sondrehr/Flight_Controller/Drone Pictures/Error codes.PNG

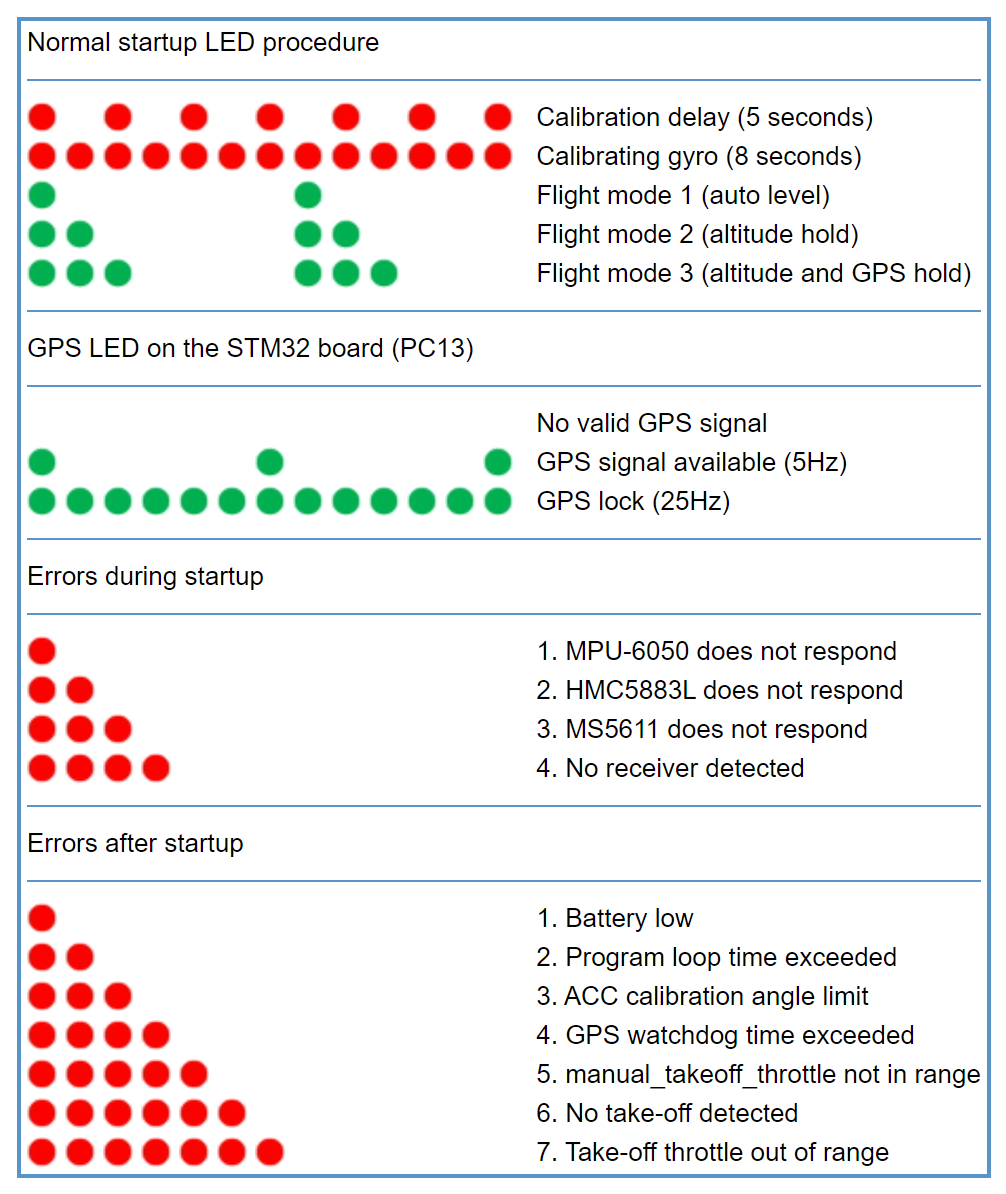
Drone Pictures/Error codes.PNG
