sondrehr/Flight_Controller/Drone Pictures/IMG_20191018_124647.jpg

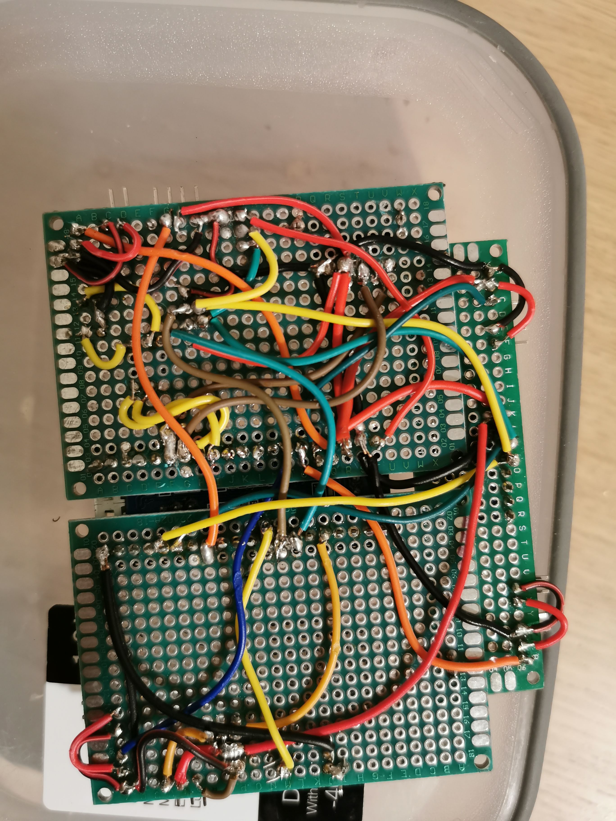
Drone Pictures/IMG_20191018_124647.jpg
