sondrehr/Flight_Controller/Drone Pictures/IMG_20191018_124652.jpg

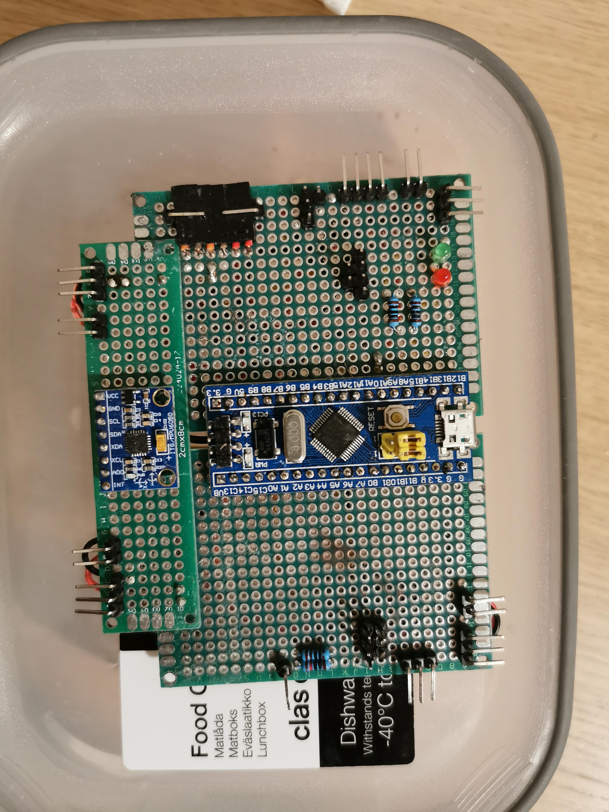
Drone Pictures/IMG_20191018_124652.jpg
