sondrehr/Flight_Controller/Drone Pictures/IMG_20200118_231146.jpg

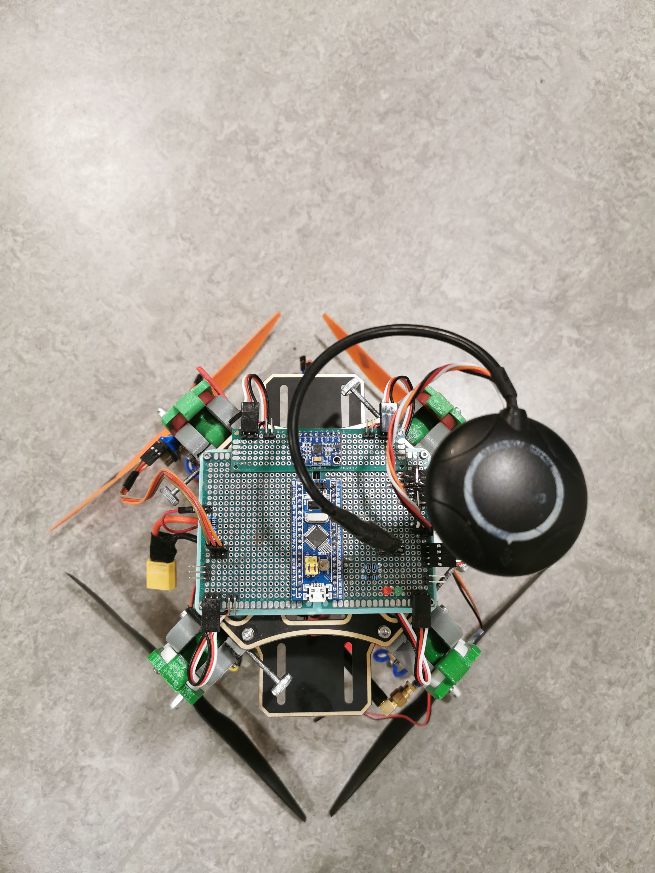
Drone Pictures/IMG_20200118_231146.jpg
