sondrehr/Flight_Controller/Drone Pictures/IMG_20210730_152356.jpg

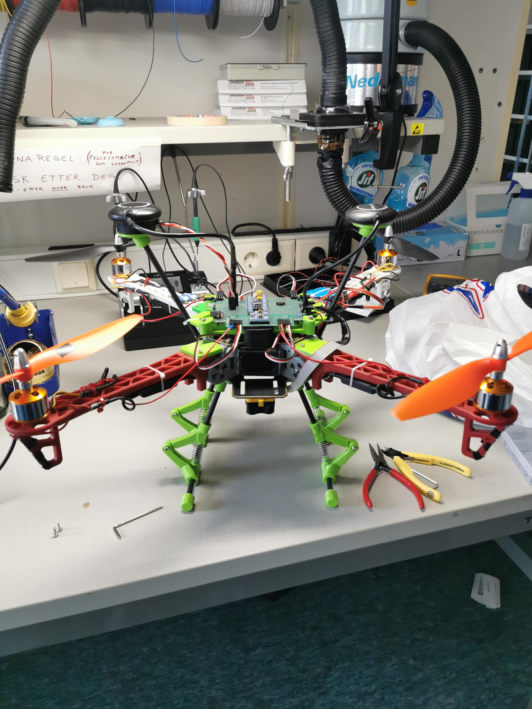
Drone Pictures/IMG_20210730_152356.jpg
