sondrehr/Flight_Controller/Drone Pictures/IMG_20210730_162122.jpg

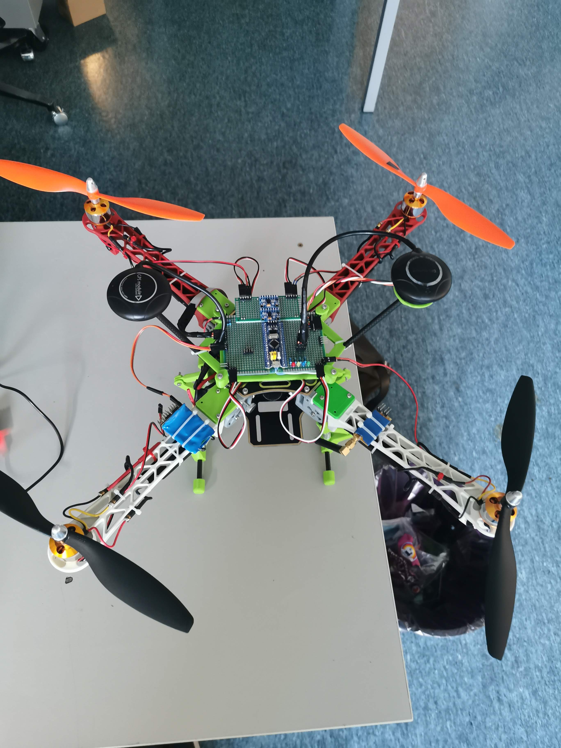
Drone Pictures/IMG_20210730_162122.jpg
