sondrehr/Flight_Controller/Drone Pictures/IMG_20210730_162133.jpg

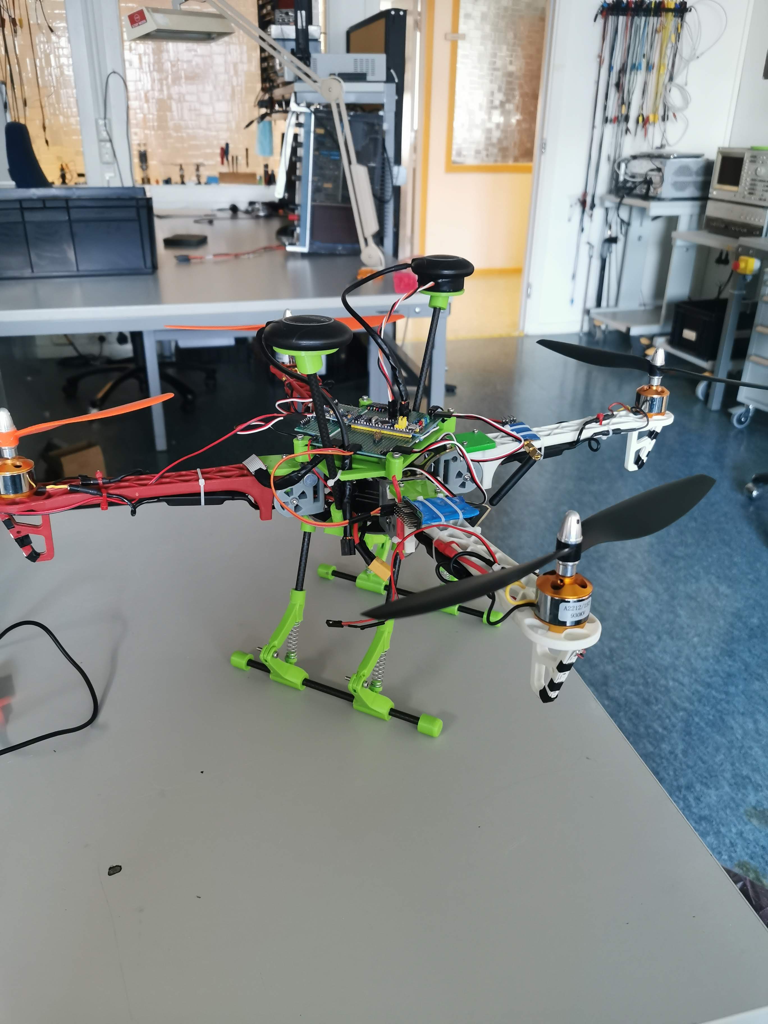
Drone Pictures/IMG_20210730_162133.jpg
