sondrehr/Flight_Controller/CAD models/diyDroneDamper-6.2.step

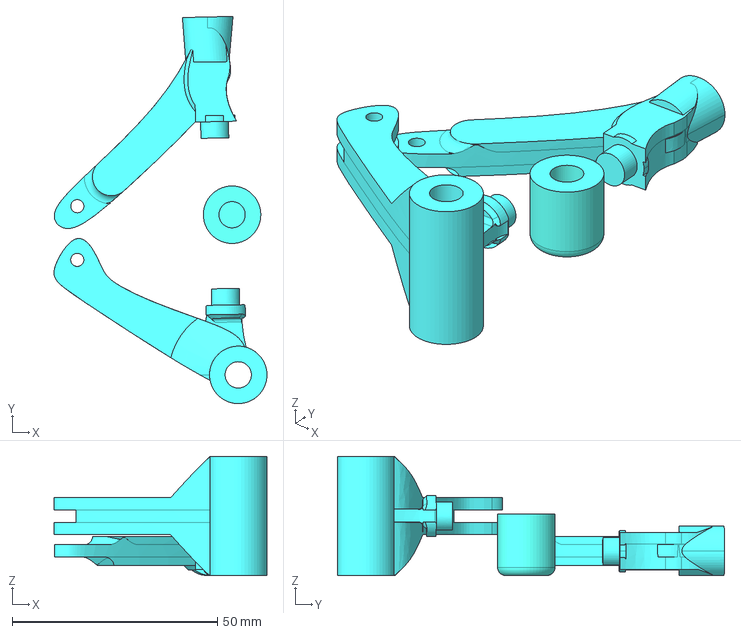
[picture p20: CAD file, 2024-04-07]
CAD models/diyDroneDamper-6.2.step
51.9 x 94.3 x 29.0 mm
