sondrehr/Flight_Controller/CAD models/diyDroneFlightController-2.0.step

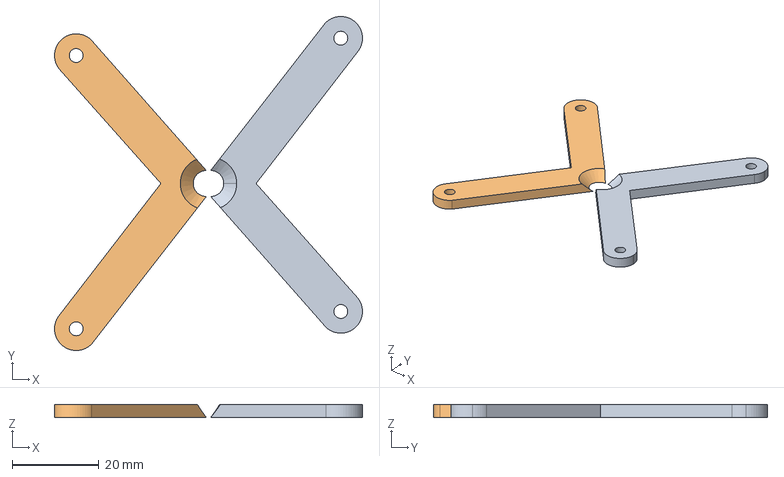
[picture p21: CAD file, 2024-04-07]
CAD models/diyDroneFlightController-2.0.step
71.0 x 77.0 x 3.00 mm
