sondrehr/Flight_Controller/CAD models/diyDroneGPS-2.1.step

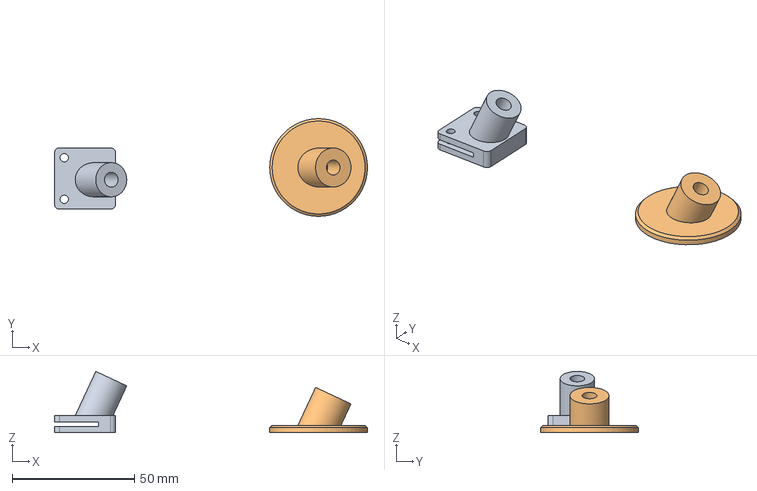
[picture p22: CAD file, 2024-04-07]
CAD models/diyDroneGPS-2.1.step
128.0 x 40.0 x 25.0 mm
