sondrehr/Flight_Controller/CAD models/diyDroneLegs-1.1.step

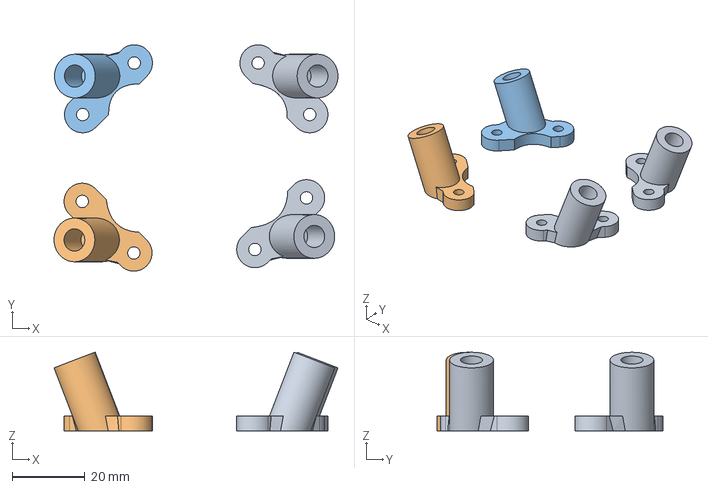
[picture p23: CAD file, 2024-04-07]
CAD models/diyDroneLegs-1.1.step
77.9 x 62.1 x 21.6 mm
