sondrehr/Flight_Controller/CAD models/diyDroneFolder-2.0.step

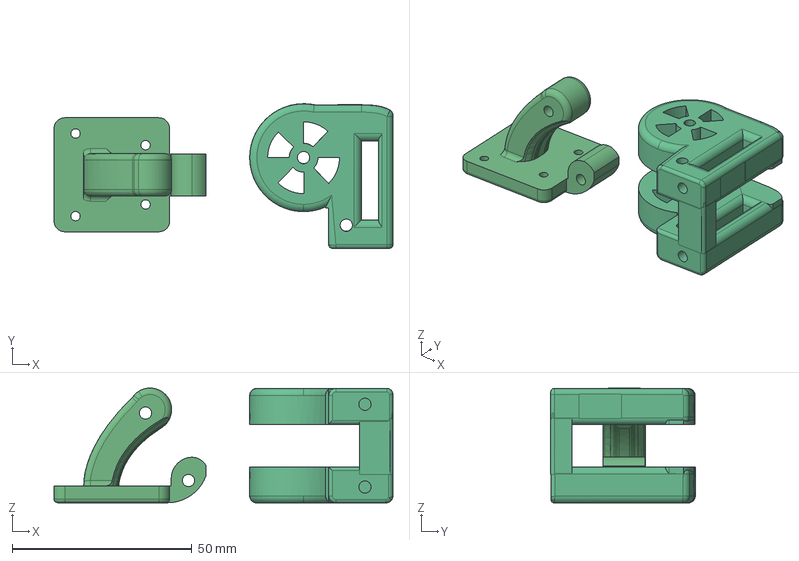
[picture p24: CAD file, 2024-04-07]
CAD models/diyDroneFolder-2.0.step
94.4 x 40.3 x 32.0 mm
