sondrehr/Flight_Controller/CAD models/diyDroneBarometer-1.0.step

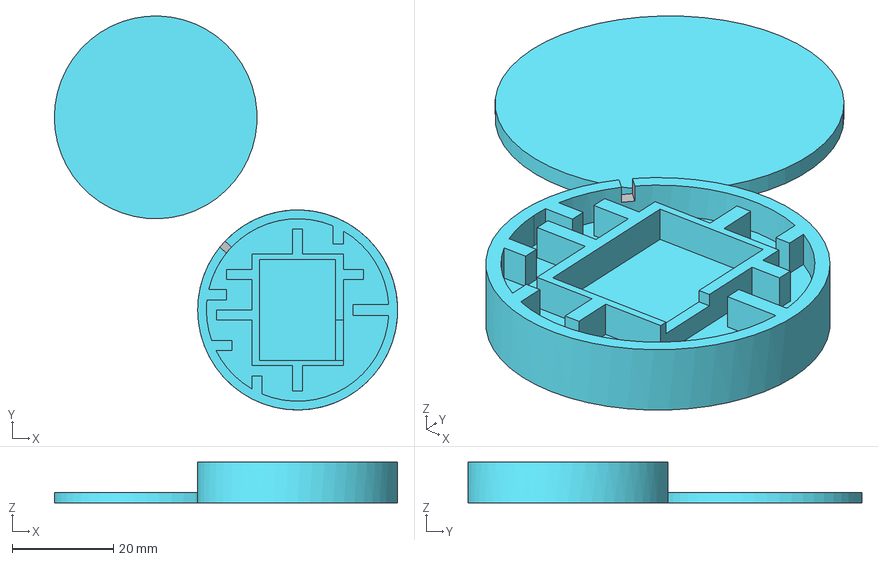
[picture p25: CAD file, 2024-04-07]
CAD models/diyDroneBarometer-1.0.step
67.7 x 77.7 x 8.00 mm
