sondrehr/Flight_Controller/CAD models/diyDroneLegs-6.1.step

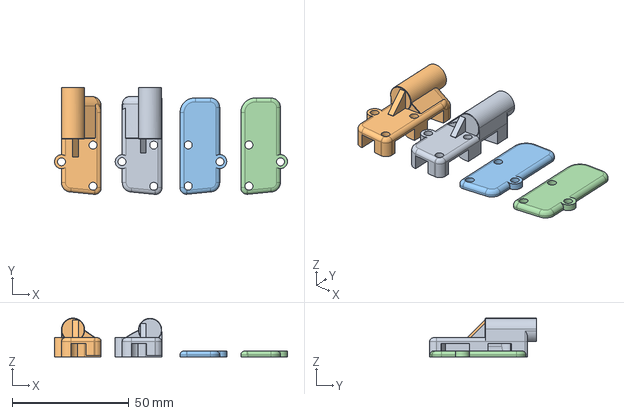
[picture p26: CAD file, 2024-04-07]
CAD models/diyDroneLegs-6.1.step
99.8 x 45.7 x 16.6 mm
