sondrehr/Flight_Controller/(threads)

Thread 1 (2024-04-04):

3D-printed parts files

theom4, 2024-04-04:
Hello Sondre,I have got the same drone frame and I would like to build a drone by myself but unfortunately my battery will not fit in that space.Could you please attach on this repo the 3D-printed components,such as that gray cylinder used to lift up the arms of the drone?
Thanks in advance!

Closed 2024-04-06.
