sondrehr/Flight_Controller/PCB kiCAD/flight controller.pdf

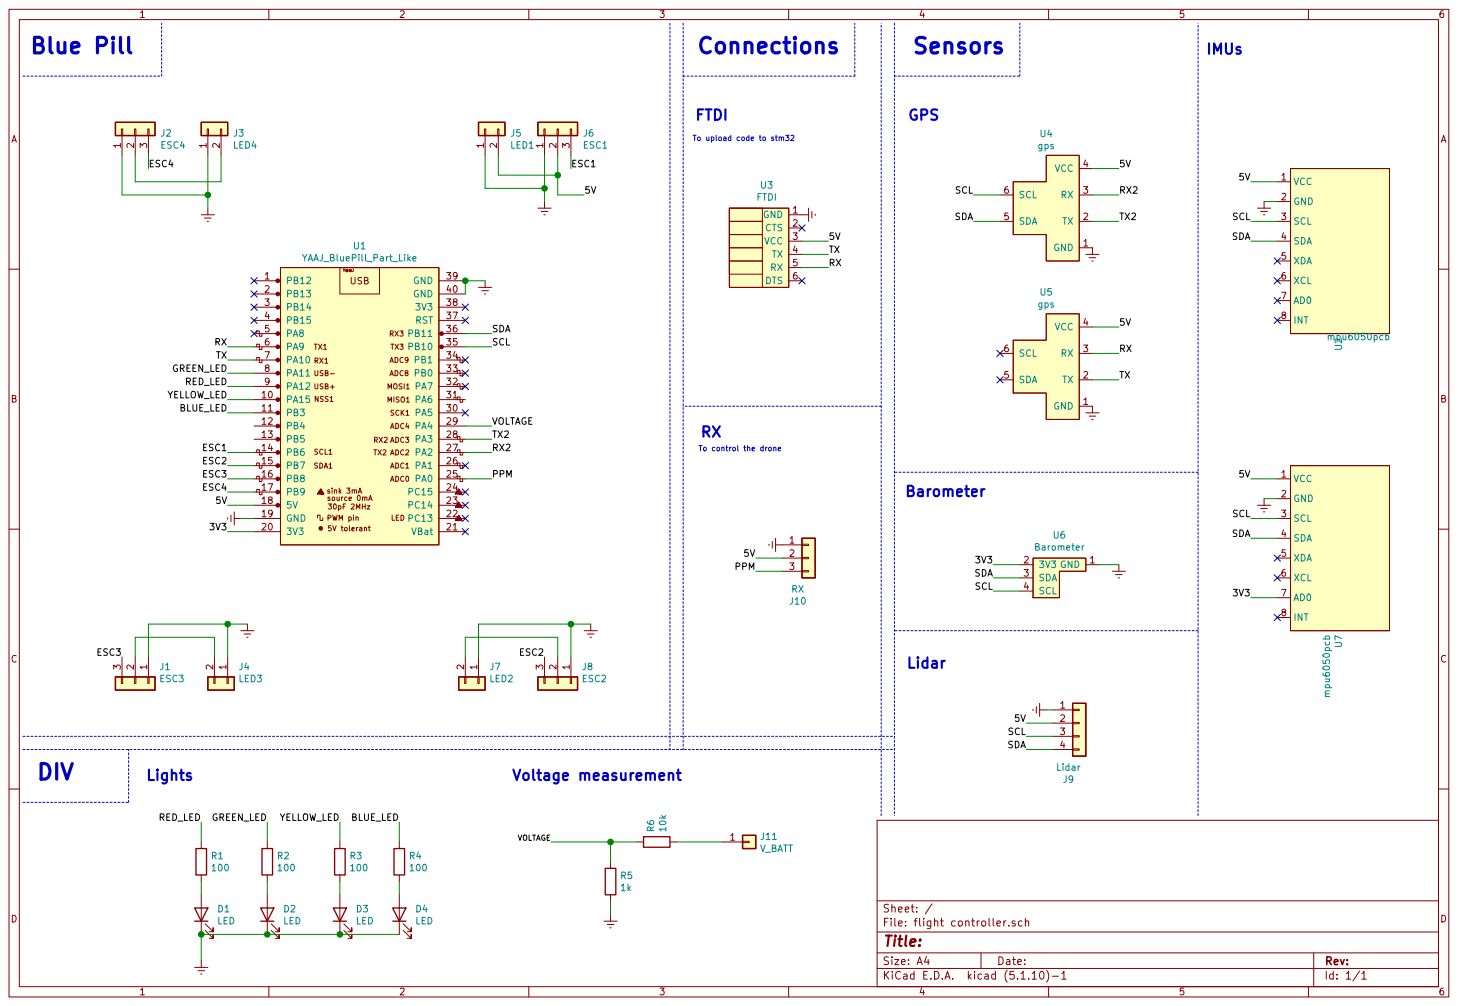
[picture p27: page 1]

FTDI To upload code to stm32 RX

To control the drone
