sondrehr/Flight_Controller/PCB kiCAD/flight controller.kicad_pcb

## KiCad design PCB kiCAD/flight controller.kicad_pcb (2022-01-11)

Schematic: flight controller.sch

Parts:
D1, D2, D3, D4: LED; LED_D4.0mm
J1: ESC3; PinHeader_1x03_P2.54mm_Horizontal
J2: ESC4; PinHeader_1x03_P2.54mm_Horizontal
J3: LED4; PinHeader_1x02_P2.54mm_Horizontal
J4: LED3; PinHeader_1x02_P2.54mm_Horizontal
J5: LED1; PinHeader_1x02_P2.54mm_Horizontal
J6: ESC1; PinHeader_1x03_P2.54mm_Horizontal
J7: LED2; PinHeader_1x02_P2.54mm_Horizontal
J8: ESC2; PinHeader_1x03_P2.54mm_Horizontal
J9: Lidar; PinHeader_1x04_P2.54mm_Horizontal
J10: RX; PinHeader_1x03_P2.54mm_Horizontal
J11: V_BATT; PinHeader_1x01_P2.54mm_Horizontal
R1, R2, R3, R4: 100; R_Axial_DIN0411_L9.9mm_D3.6mm_P12.70mm_Horizontal
R5: 1k; R_Axial_DIN0411_L9.9mm_D3.6mm_P12.70mm_Horizontal
R6: 10k; R_Axial_DIN0411_L9.9mm_D3.6mm_P12.70mm_Horizontal
U1: YAAJ_BluePill_Part_Like; YAAJ_BluePill_1
U2, U7: mpu6050pcb; IMU
U3: FTDI; Socket_Strip_Angled_1x06_Pitch2.54mm
U4, U5: gps; GPS
U6: Barometer

Connections:
/3V3: U1.20 (3V3), U6.2 (3V3), U7.7
/5V: J5.2, J6.2, J9.2, J10.2, U1.18 (5V), U2.1, U3.3 (VCC), U4.1 (VCC), U5.1 (VCC), U7.1
/BLUE_LED: R4.1, U1.11 (PB3)
/ESC1: J6.3, U1.14 (PB6)
/ESC2: J8.3, U1.15 (PB7)
/ESC3: J1.3, U1.16 (PB8)
/ESC4: J2.3, U1.17 (PB9)
/GREEN_LED: R2.1, U1.8 (PA11)
/PPM: J10.3, U1.25 (PA0)
/RED_LED: R1.1, U1.9 (PA12)
/RX: U1.6 (PA9), U3.5 (RX), U5.2 (RX)
/RX2: U1.27 (PA2), U4.2 (RX)
/SCL: J9.3, U1.35 (PB10), U2.3, U4.5 (SCL), U6.4 (SCL), U7.3
/SDA: J9.4, U1.36 (PB11), U2.4, U4.6 (SDA), U6.3 (SDA), U7.4
/TX: U1.7 (PA10), U3.4 (TX), U5.3 (TX)
/TX2: U1.28 (PA3), U4.3 (TX)
/VOLTAGE: R5.1, R6.1, U1.29 (PA4)
/YELLOW_LED: R3.1, U1.10 (PA15)
Earth: D1.1 (K), D2.1 (K), D3.1 (K), D4.1 (K), J1.1, J2.1, J3.1, J4.1, J5.1, J6.1, J7.1, J8.1, J9.1, J10.1, R5.2, U1.19 (GND), U1.39 (GND), U1.40 (GND), U2.2, U3.1 (GND), U4.4 (GND), U5.4 (GND), U6.1 (GND), U7.2
unnamed: D1.2 (A), R1.2
unnamed: D2.2 (A), R2.2
unnamed: D3.2 (A), R3.2
unnamed: D4.2 (A), R4.2
unnamed: J1.2, J4.2
unnamed: J2.2, J3.2
unnamed: J7.2, J8.2
unnamed: J11.1, R6.2

Notes on the sheet:
Lights
Voltage measurement
To control the drone
To upload code to stm32
FTDI
Lidar
Barometer
GPS
IMUs
DIV
Blue Pill
Connections
Sensors

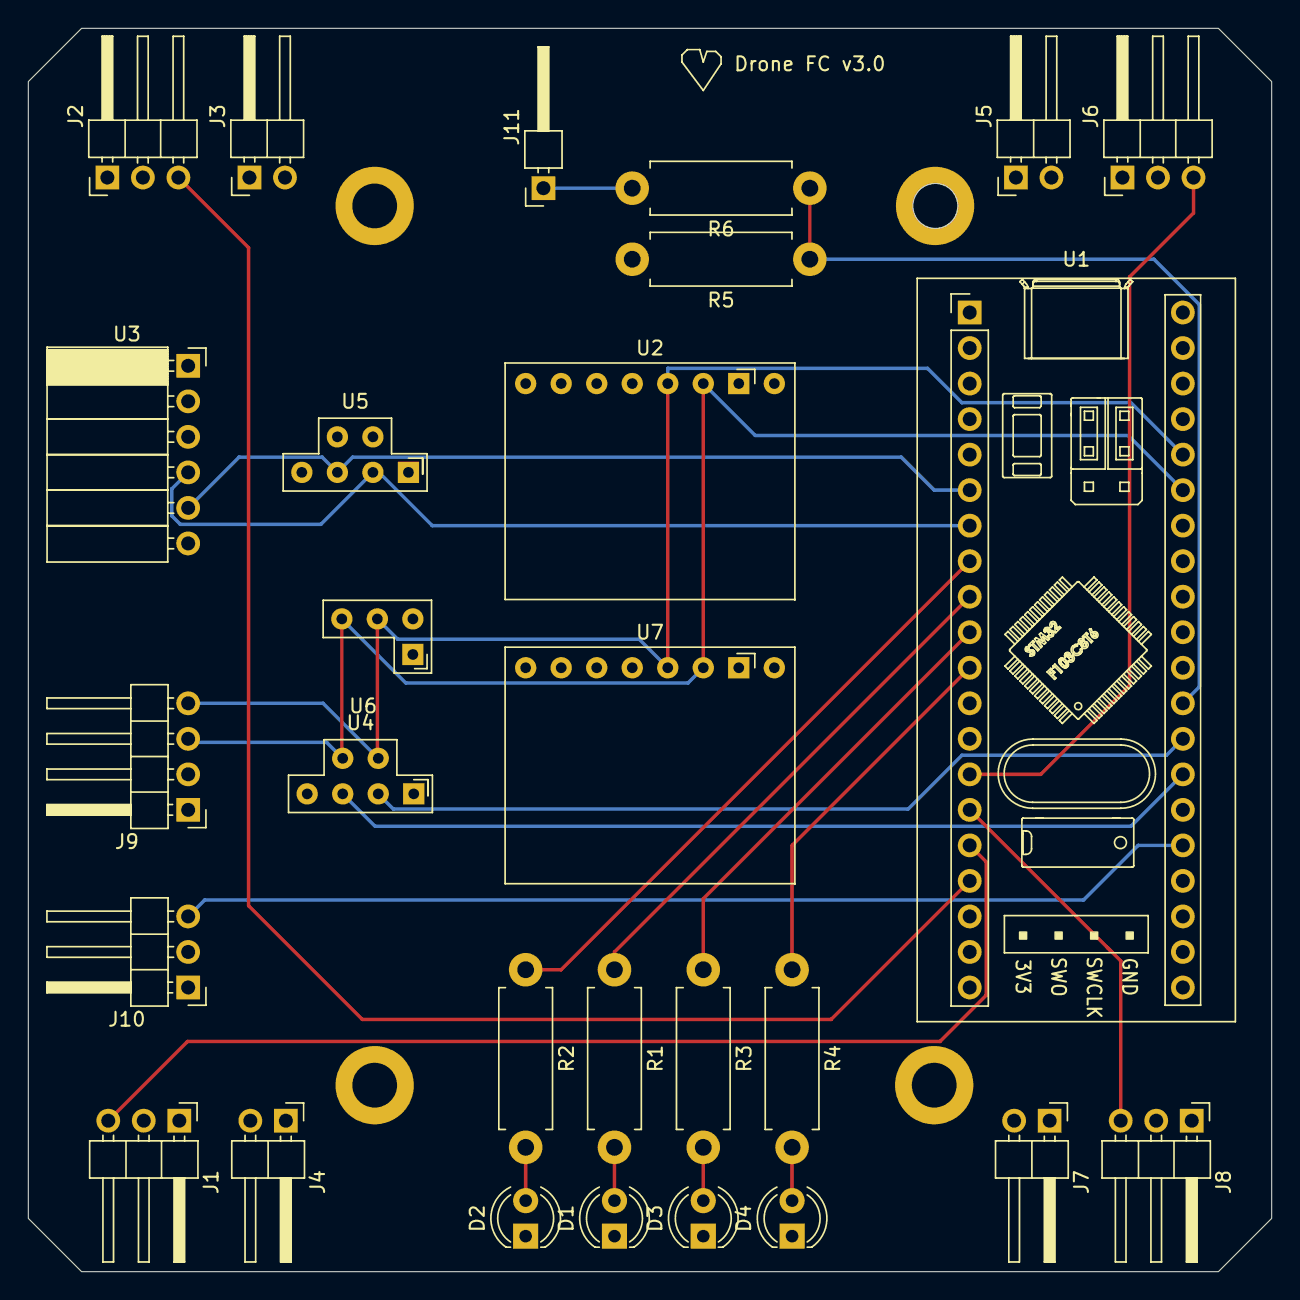
[picture p28: board flight controller.kicad_pcb from above]

Board: 4 copper layers, 88.9 x 88.9 mm, 28 parts (0 on the bottom side), 27 nets.
