sondrehr/Flight_Controller/(commit log)

2020-01-21 Diverse småfeil og la til kommentarer
2021-11-16 pcb schematic
2021-11-16 pcb cleanup
2021-11-21 pcb and 3d modell
2021-11-21 fix schematic png
    [flight controller.kicad_pcb, flight controller.sch]
2021-11-21 revise pcb
    [flight controller.kicad_pcb]
2022-01-11 ny pcb
    [flight controller-B_Cu.gbr, flight controller-B_Fab.gbr, flight controller-B_Mask.gbr, flight controller-B_Paste.gbr, flight controller-B_SilkS.gbr, flight controller-Edge_Cuts.gbr, flight controller-F_Cu.gbr, flight controller-F_Fab.gbr]
2022-01-11 fikse bilder
    [flight controller.kicad_pcb]
2022-01-11 pcb v3
2024-04-07 added step files
    [diyDroneBarometer-1.0.step, diyDroneDamper-6.2.step, diyDroneFlightController-2.0.step, diyDroneFolder-2.0.step, diyDroneGPS-2.1.step, diyDroneLegs-1.1.step, diyDroneLegs-6.1.step]
